nf-zvv/IVC_Tracer_v2/(commit log)

2020-03-23 added uart terminal
2020-07-23 STR_TO_UINT16 replaced by atoi
    [cmd_func.asm]
2020-07-28 UART CMD PARSE: added processing of special chars
2020-07-29 some DEC_TO_STR5 replaced with ITOA; ITOA-dependent fixes
    [IVC_Tracer_v2.asm, cmd_func.asm, simple_menu.asm, uart_funcs.asm]
2020-07-29 new PRINT_IVC_DATA_TO_UART_2
2020-07-30 auto IVC traceing
2020-07-31 auto IVC tracing fixed
    [IVC_Tracer_v2.asm, simple_menu.asm]
2021-10-19 moved from Timer0 OVF mode to CTC mode
2021-10-19 added 1ms system timer SYS_TICK_MS
